ayush-1910/Smart-Irrigation-System/docs/MNNIT Internship Certificate (Summer'26 - AT).pdf

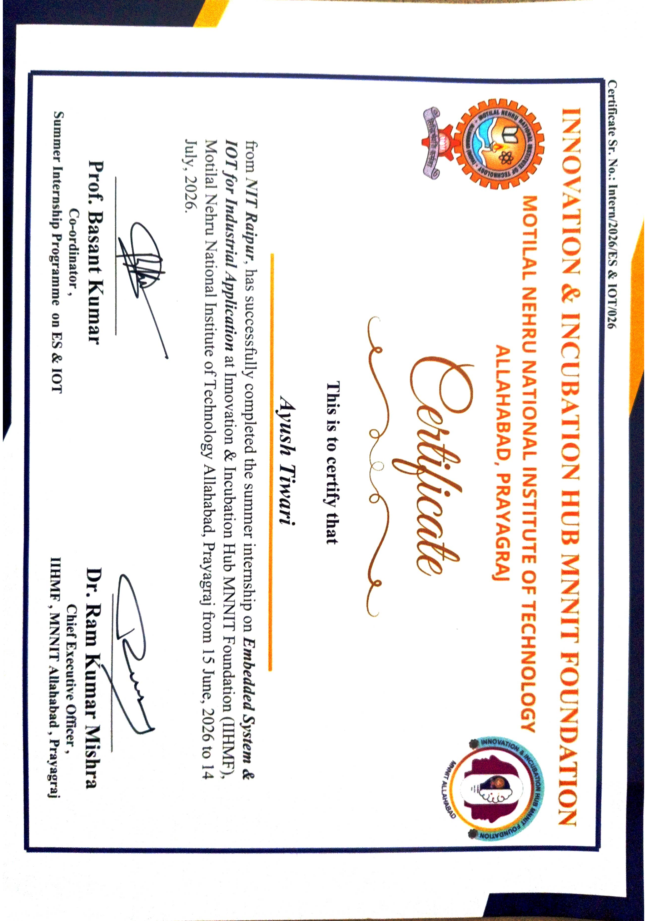
[picture p35: page 1]
